gorbit99/tiny-slime/Case/tiny-slime-case-Bottom.3mf

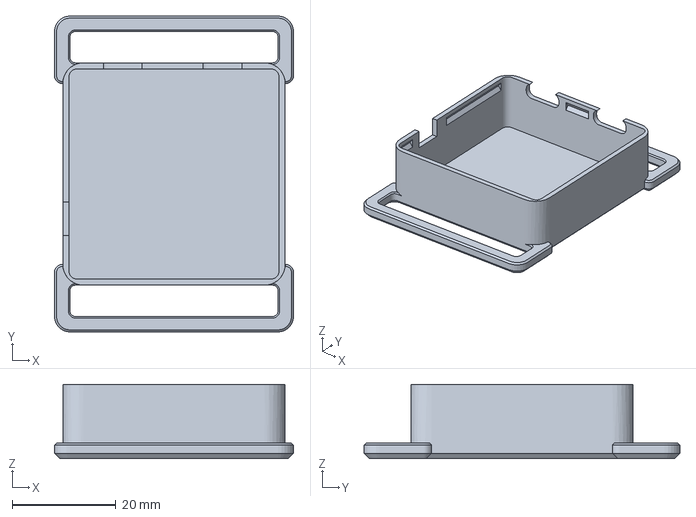
[picture p6: CAD file, 2024-02-03]
Case/tiny-slime-case-Bottom.3mf
46.0 x 60.8 x 14.3 mm
