gorbit99/tiny-slime/custom_models/tp4056.step

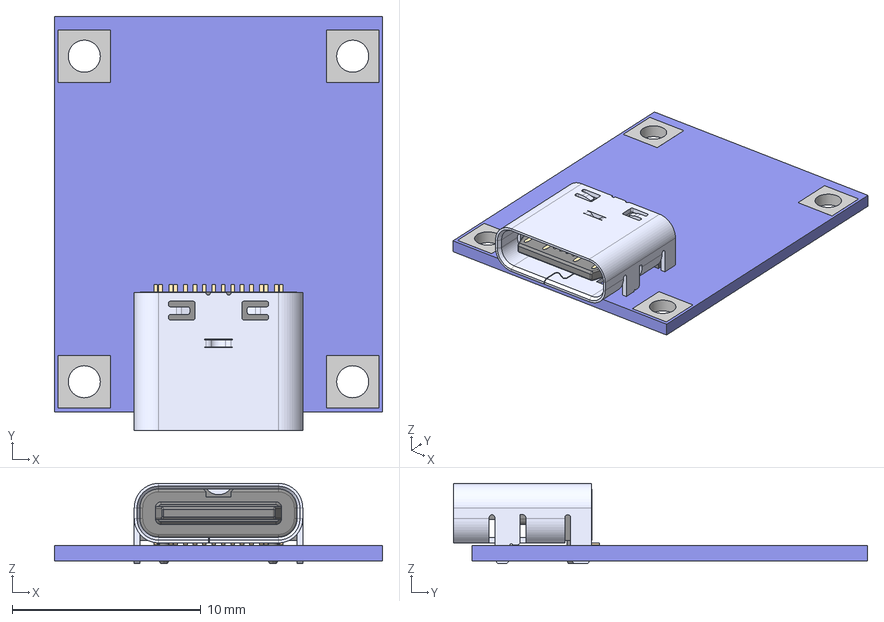
[picture p7: CAD file, 2024-01-30]
custom_models/tp4056.step
17.4 x 22.0 x 4.26 mm
Pads
CQ-USB-C16PSMT01
