gorbit99/tiny-slime/Case/tiny-slime-case.FCStd

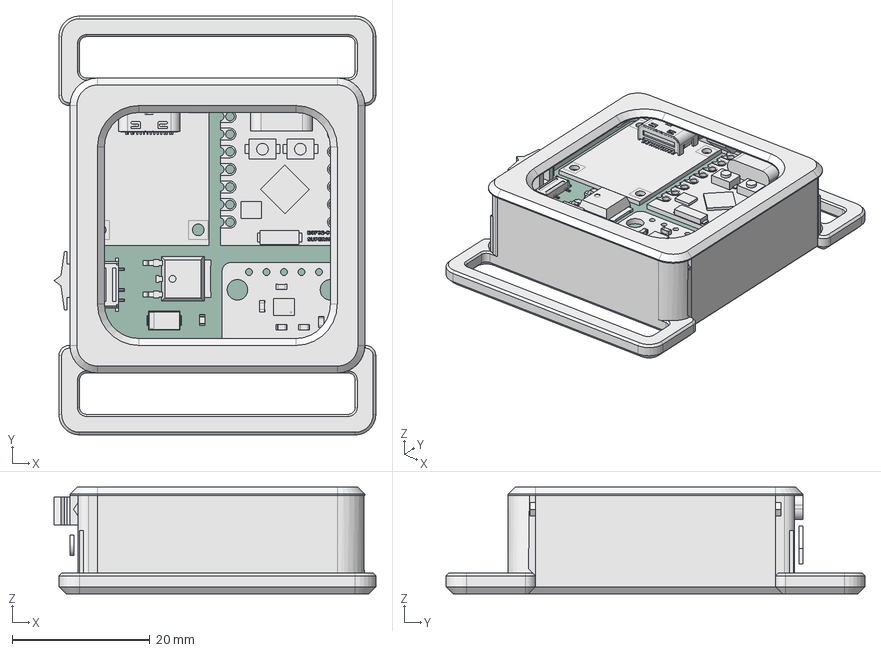
[picture p8: CAD file, 2024-02-03]
Case/tiny-slime-case.FCStd
46.7 x 60.8 x 15.5 mm
tiny-slime PCB
Battery
Bottom
Switch
Top
