gorbit99/tiny-slime/custom_models/meia_lsm.step

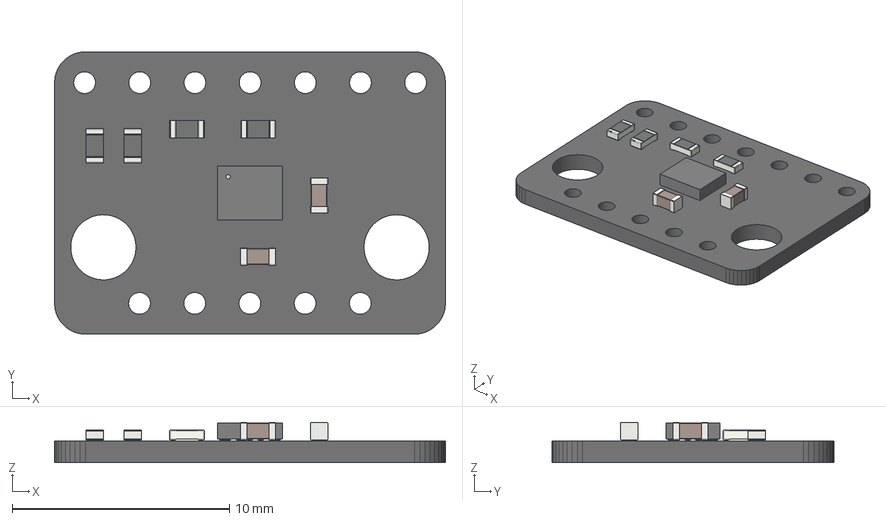
[picture p9: CAD file, 2023-12-29]
custom_models/meia_lsm.step
18.0 x 13.0 x 1.85 mm
LSM6DSV Module PCB
