gorbit99/tiny-slime/Case/tiny-slime-case-Switch.3mf

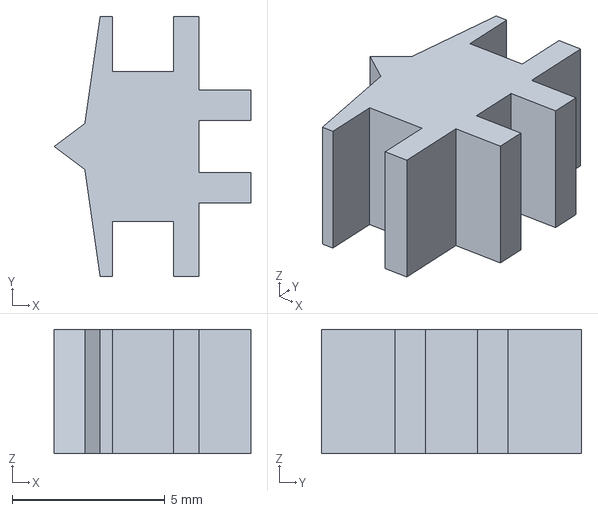
[picture p10: CAD file, 2024-02-03]
Case/tiny-slime-case-Switch.3mf
6.43 x 8.50 x 4.06 mm
