gorbit99/tiny-slime/custom_models/ESP32-C3 supermini v5.step

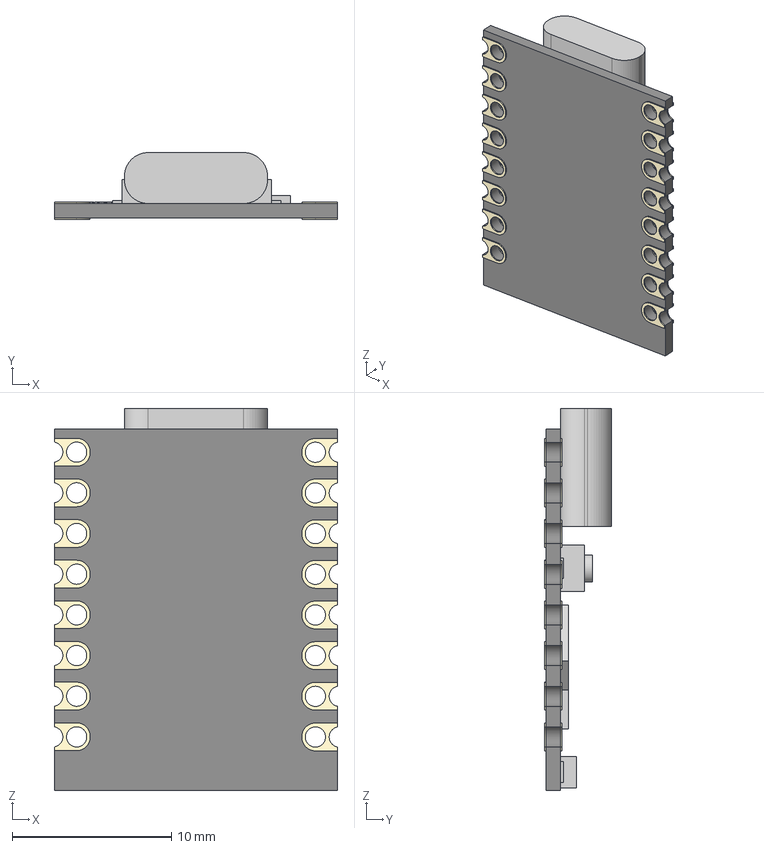
[picture p11: CAD file, 2023-12-29]
custom_models/ESP32-C3 supermini v5.step
17.8 x 4.20 x 24.0 mm
