gorbit99/tiny-slime/Case/tiny-slime-case-Top.3mf

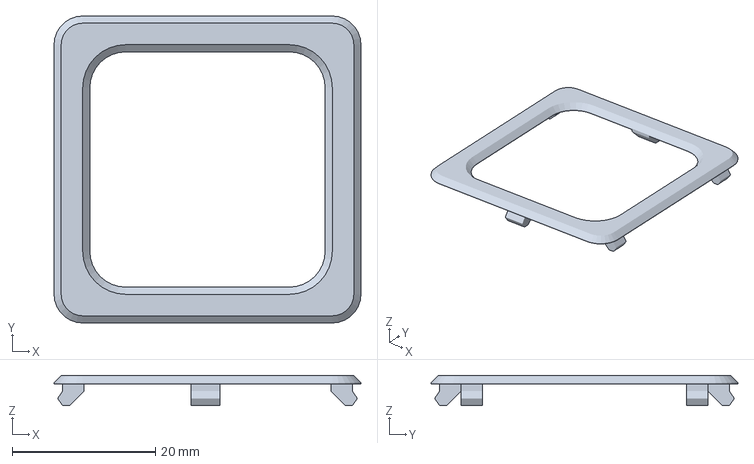
[picture p12: CAD file, 2024-02-03]
Case/tiny-slime-case-Top.3mf
42.8 x 42.8 x 4.20 mm
