gorbit99/tiny-slime/(list of files, cad)

Other CAD files:
Case/tiny-slime-case-Bottom.stl
Case/tiny-slime-case-Switch.stl
Case/tiny-slime-case-Top.stl
