gorbit99/tiny-slime/tiny-slime.pdf

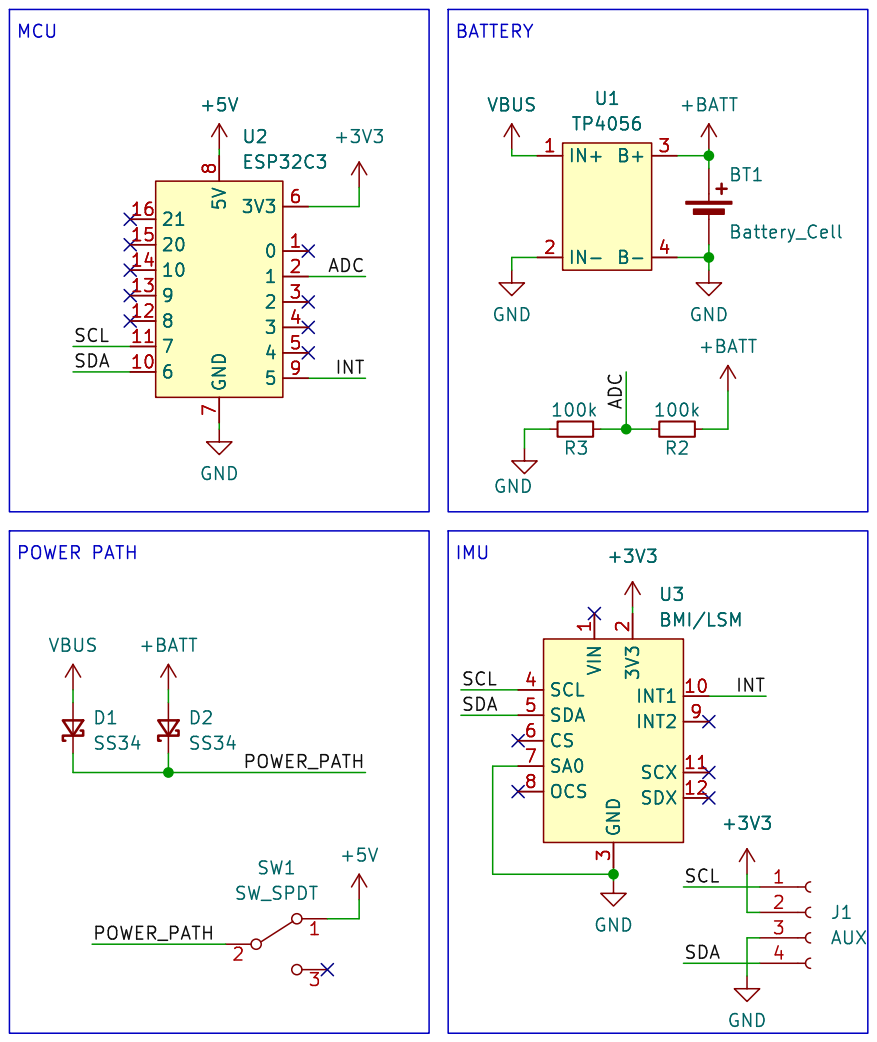
[picture p13: page 1]

Id: 1/1 Title: File: tiny-slime.kicad_sch Sheet: / VIN 1
