gorbit99/tiny-slime/(threads)

Thread 4 (2024-06-23):

PCB design issues.

Wildtimo, 2024-06-23:
There is a ground plane partially under the antenna, That's bad for signal.
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

Thread 6 (2025-06-20):

On rev 1.2 what are r1 and d3 for?

AJConnelly, 2025-06-20:
On the docs it doesn't show what these pads above the 2 diodes are for
