gorbit99/tiny-slime/(commit log)

2023-12-29 Added PCB Ordering to the README
2024-01-02 Added QR code to bottom side
    [bom.csv, positions.csv, tiny-slime.kicad_pcb, tiny-slime.kicad_sch]
2024-01-07 Added AUX pins and reroute
    [bom.csv, designators.csv, positions.csv, tiny-slime.kicad_pcb, tiny-slime.kicad_sch]
2024-01-07 Changed 0603 resistors to 1206 in the readme+
2024-01-07 Replace power path with diodes
    [bom.csv, designators.csv, positions.csv, tiny-slime.kicad_pcb, tiny-slime.kicad_sch]
2024-01-07 Fixed some layout mistakes
    [tiny-slime.kicad_pcb, tiny-slime.kicad_sch]
2024-01-30 Updated TP4056 footprint and model
    [bom.csv, designators.csv, positions.csv, tiny-slime.kicad_pcb, tp4056.step]
2024-01-30 Bumped rev number
    [tiny-slime.kicad_pcb]
2024-02-01 Added soldering and flashing instructions
2024-02-03 Added case and case info
    [tiny-slime-case-Bottom.3mf, tiny-slime-case-Switch.3mf, tiny-slime-case-Top.3mf, tiny-slime-case.FCStd]
2024-02-28 Added the sellers guide
    [bom.csv, designators.csv, positions.csv, tiny-slime.kicad_pcb, tiny-slime.kicad_sch]
2024-05-15 Fixed firmware flasher link to include the INT pin too
2024-06-22 STL files
    [tiny-slime-case-Bottom.stl, tiny-slime-case-Switch.stl, tiny-slime-case-Top.stl]
